harvie256/xmu/README.md

# xMU
An Open Power Grid Measurement Platform

Check out the blog at https://xmuopen.wordpress.com/
