harvie256/xmu/pcb/x_pmu/Datasheets/enclosure/User Library-D6MG.STEP

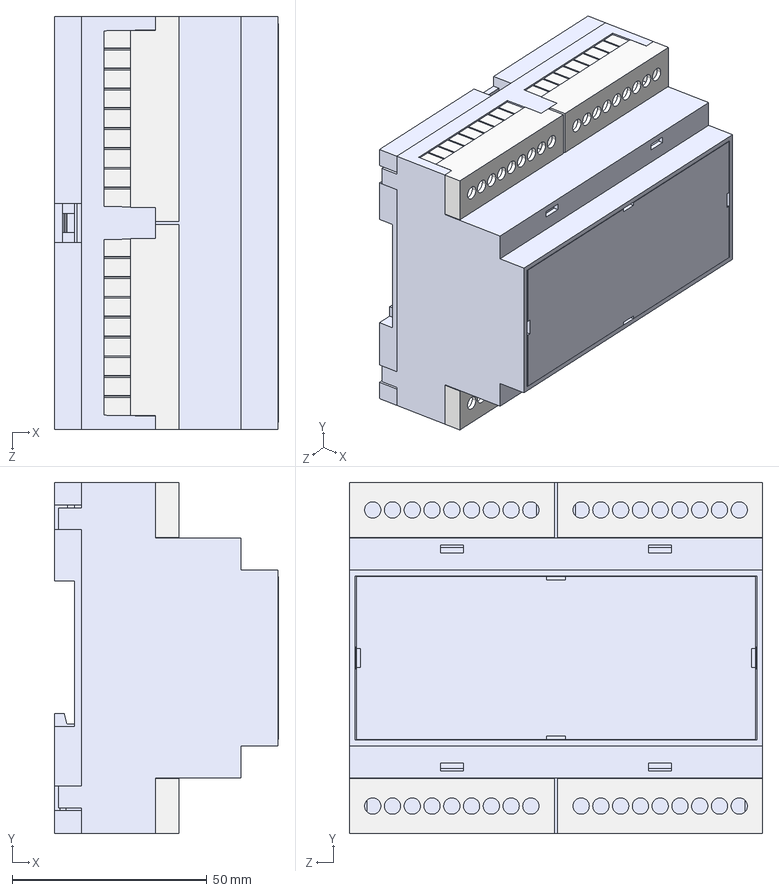
[picture p1: CAD file, 2020-08-02]
pcb/x_pmu/Datasheets/enclosure/User Library-D6MG.STEP
57.6 x 90.2 x 106.3 mm
body-D6MG___ _________
cover-D6MG___ _________
base-D6MG___ _________
guard-D6MG___ _________ x 4
