harvie256/xmu/pcb/x_pmu/Datasheets/enclosure/body-D6MG.step

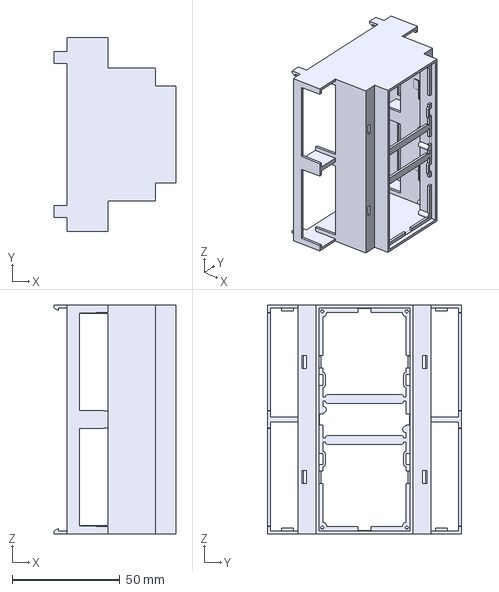
[picture p2: CAD file, 2020-08-02]
pcb/x_pmu/Datasheets/enclosure/body-D6MG.step
56.5 x 90.2 x 106.2 mm
