harvie256/xmu/pcb/x_pmu/x_pmu/x_pmu_project.pdf

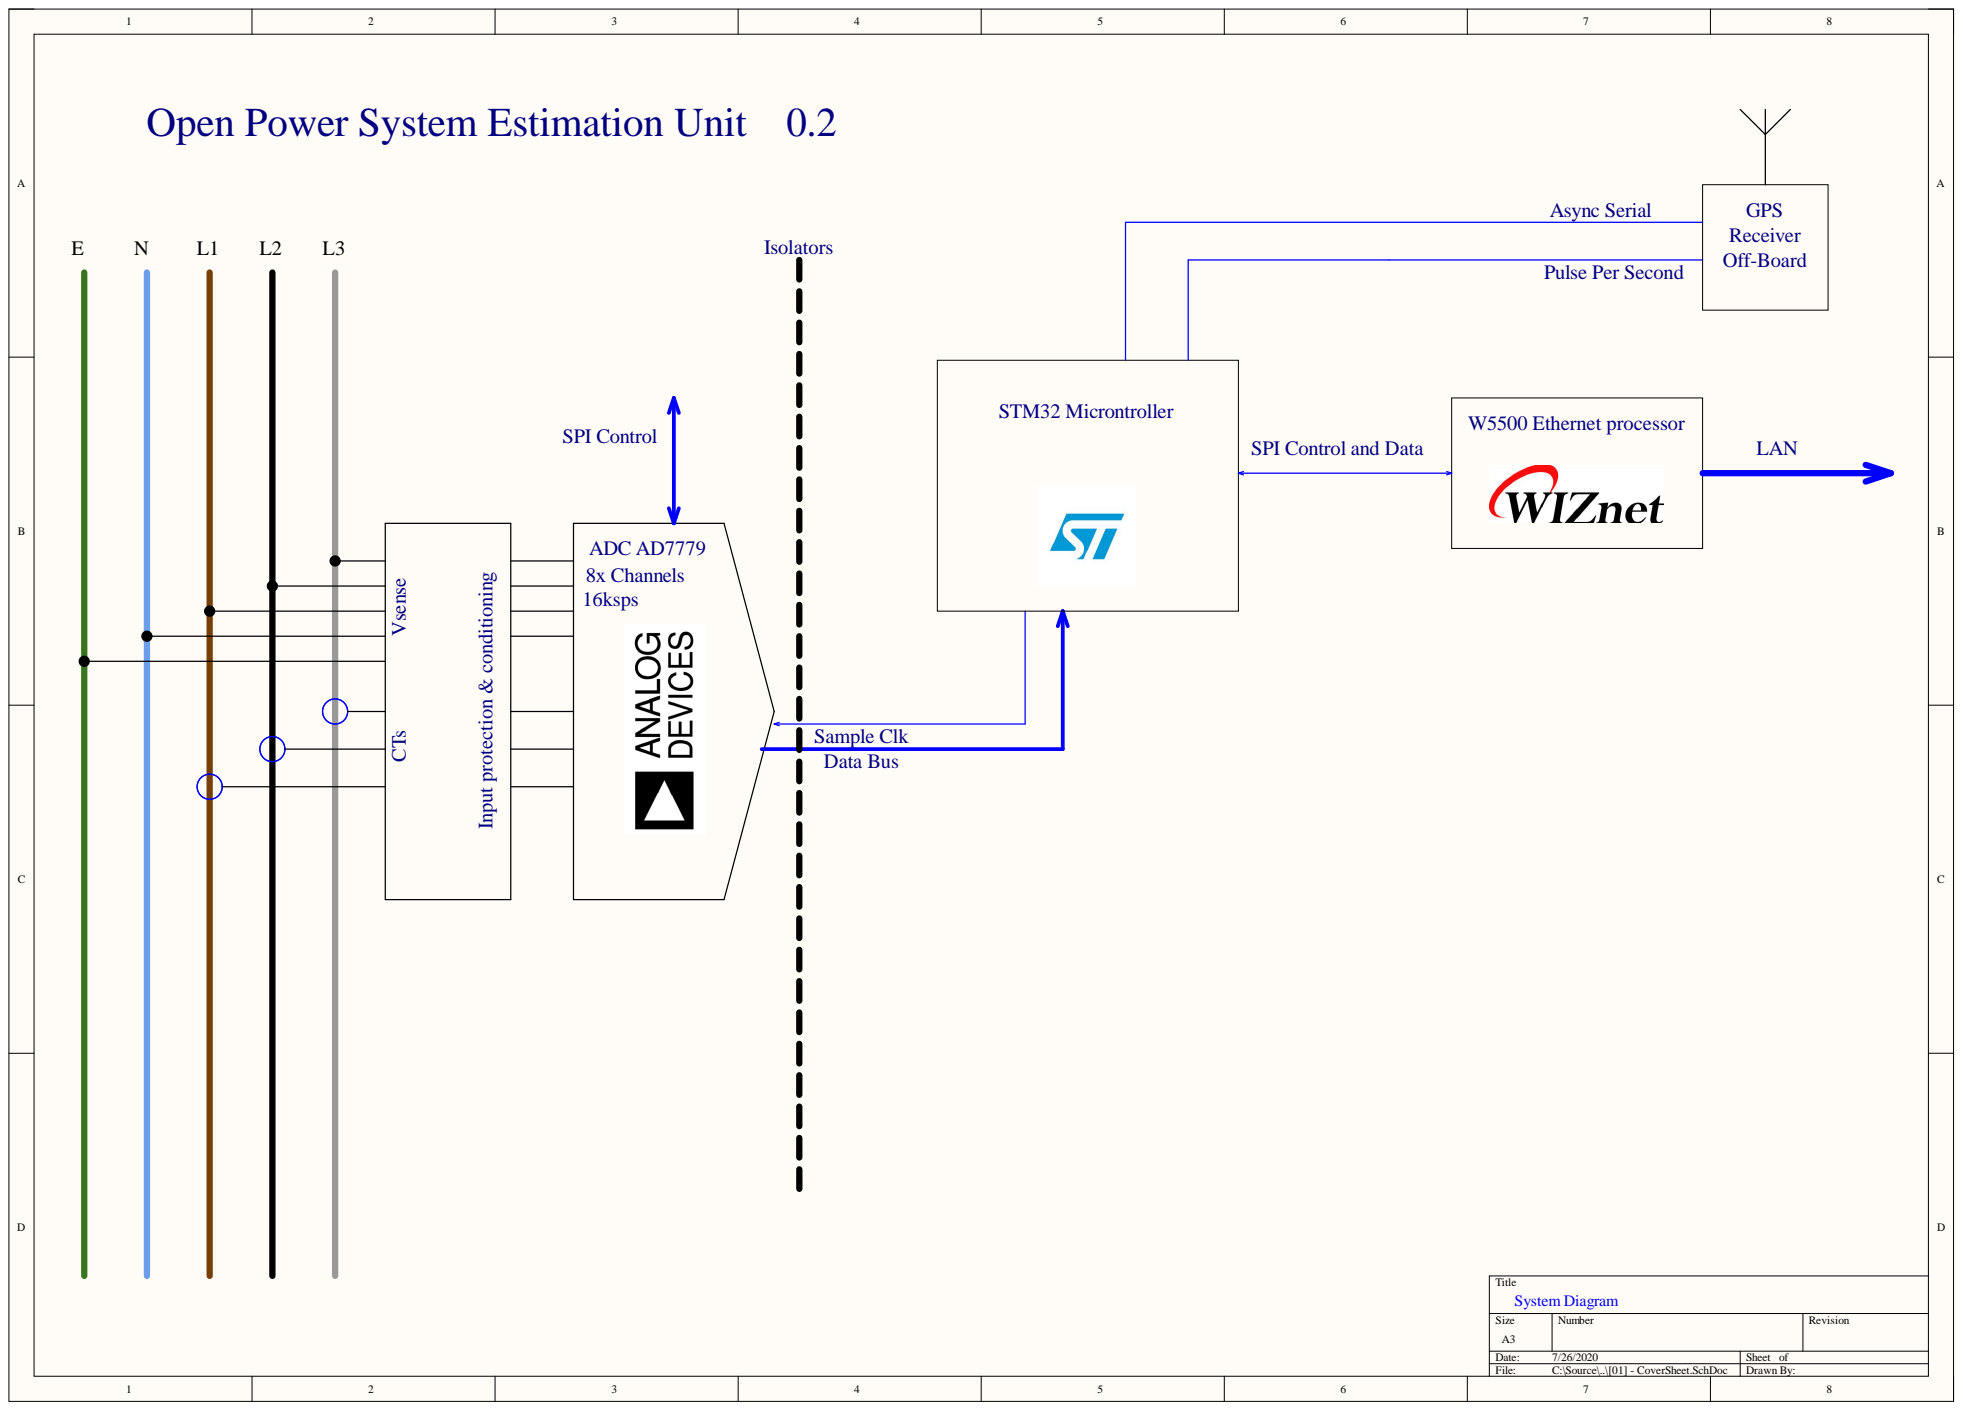
[picture p3: page 1]

Open Power System Estimation Unit 0.2

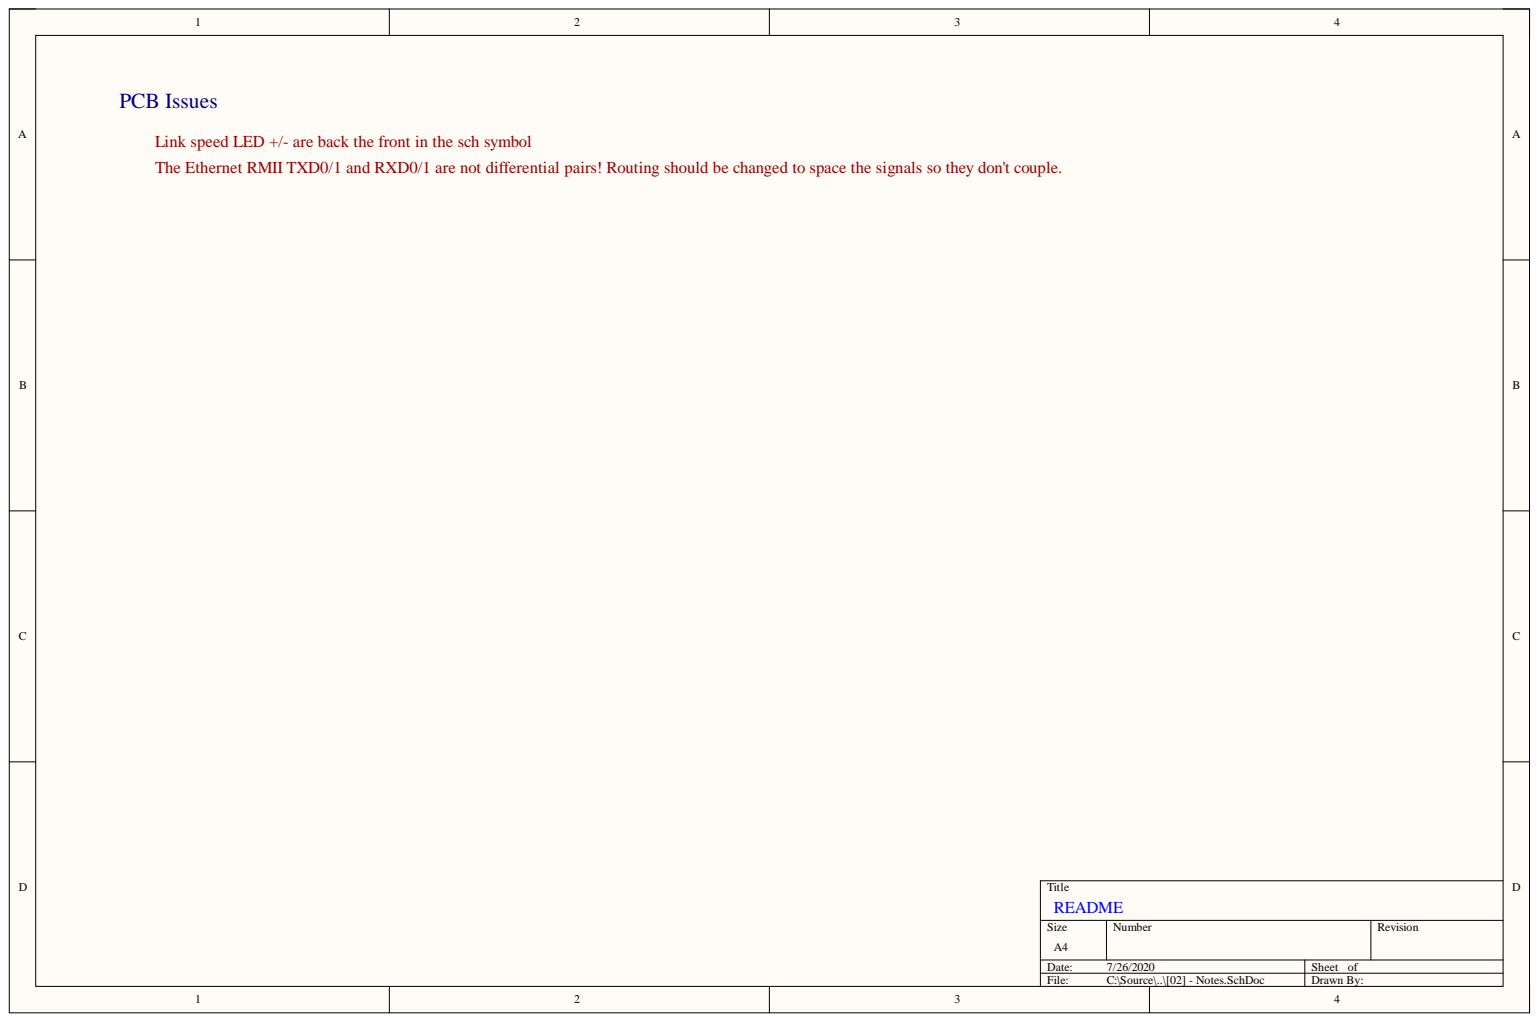
[picture p4: page 2]

Link speed LED +/- are back the front in the sch symbol
The Ethernet RMII TXD0/1 and RXD0/1 are not differential pairs! Routing should be changed to space the signals so they don't couple.

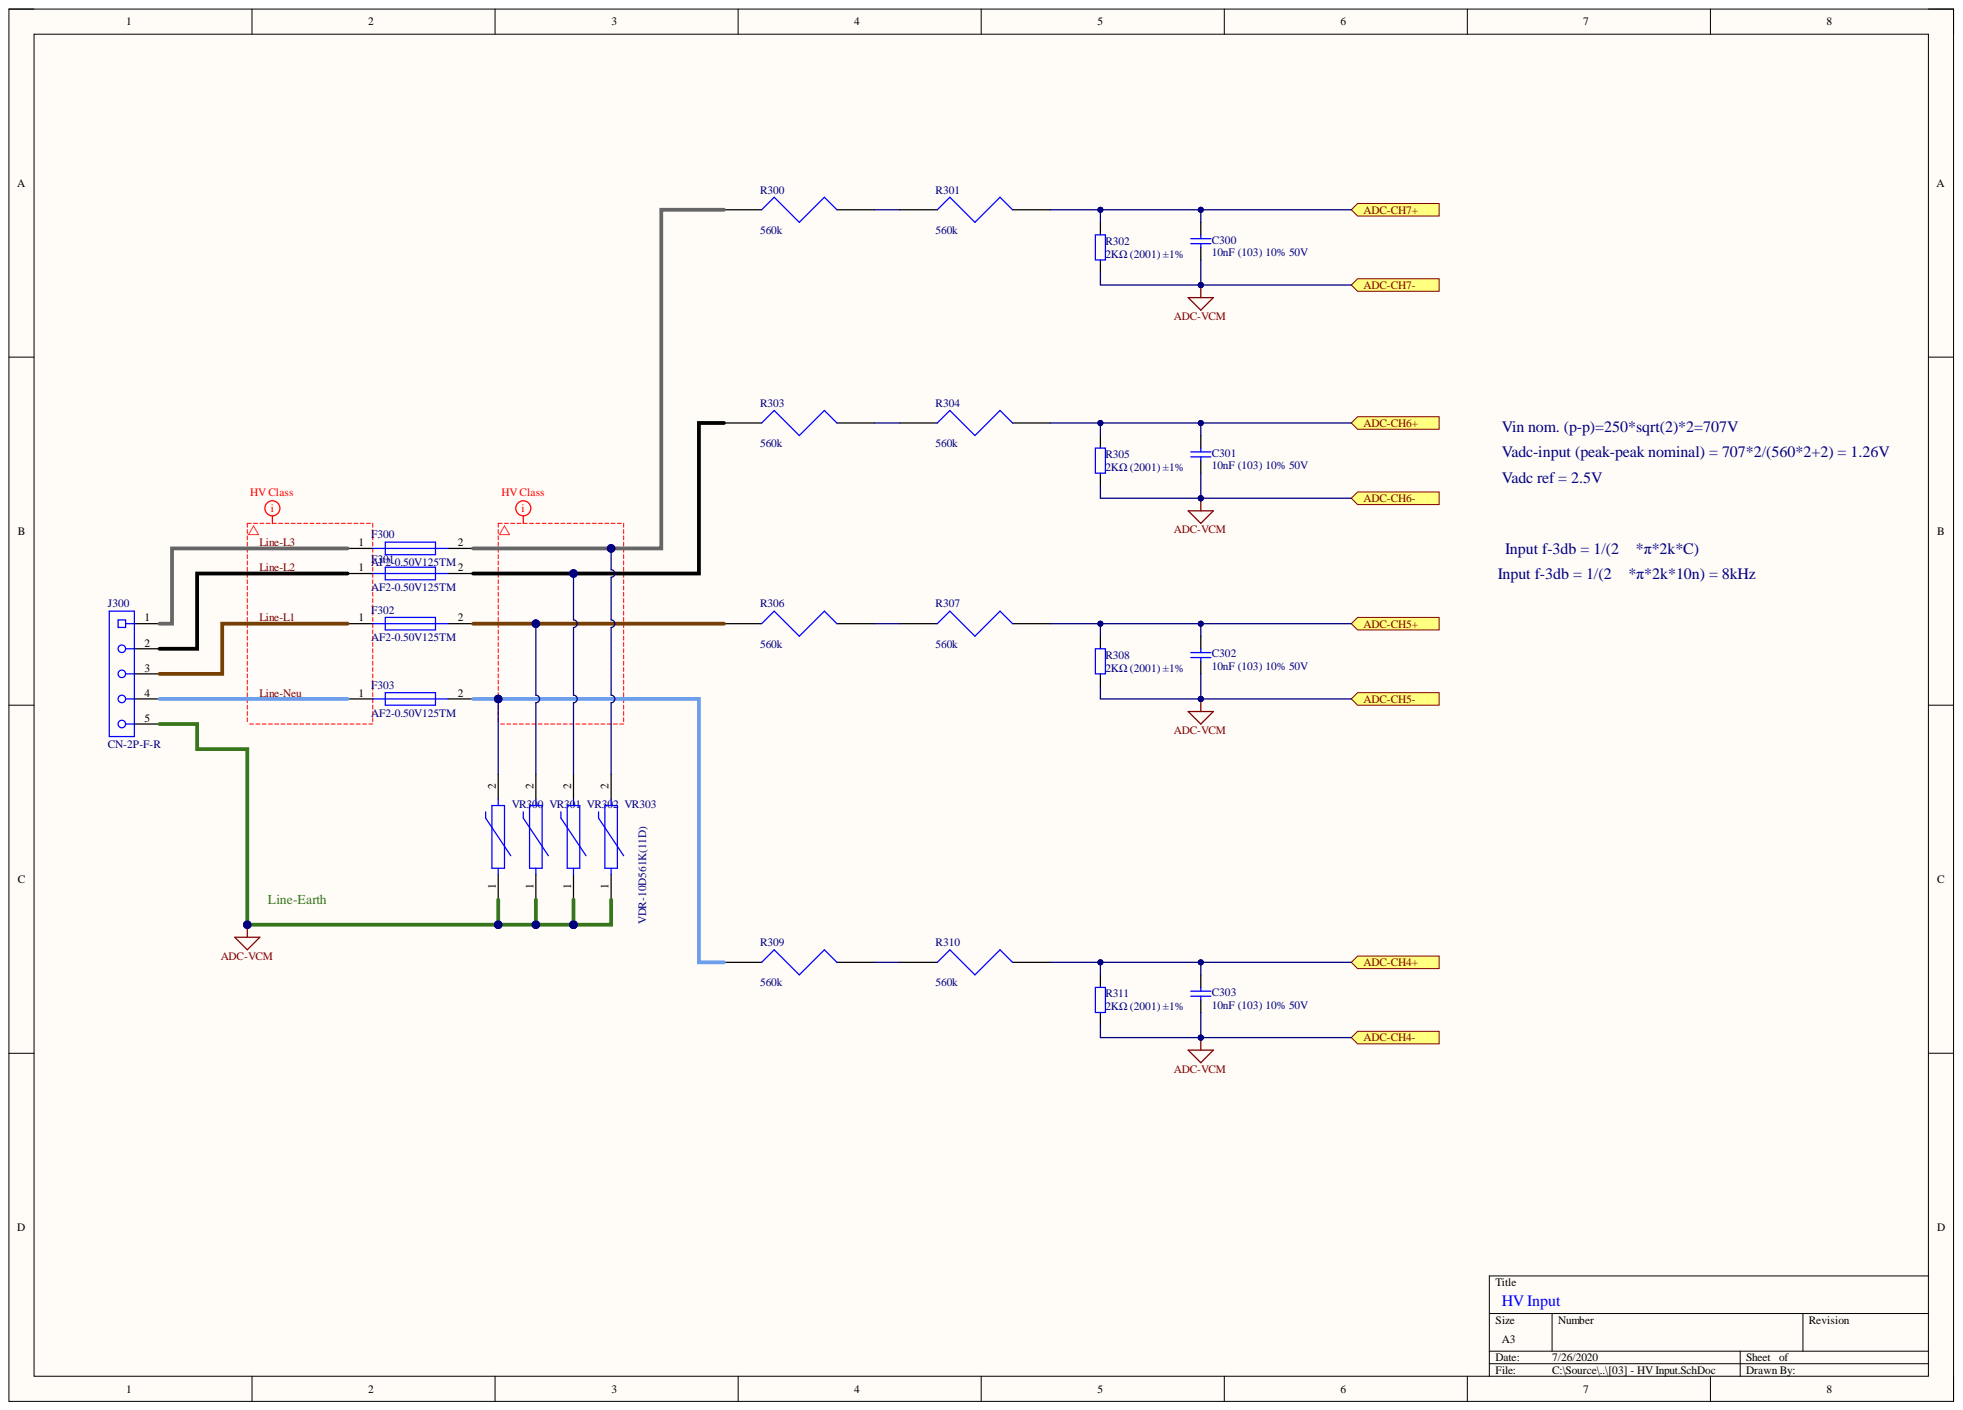
[picture p5: page 3]

Vin nom. (p-p)=250*sqrt(2)*2=707V
Vadc-input (peak-peak nominal) = 707*2/(560*2+2) = 1.26V
Vadc ref = 2.5V

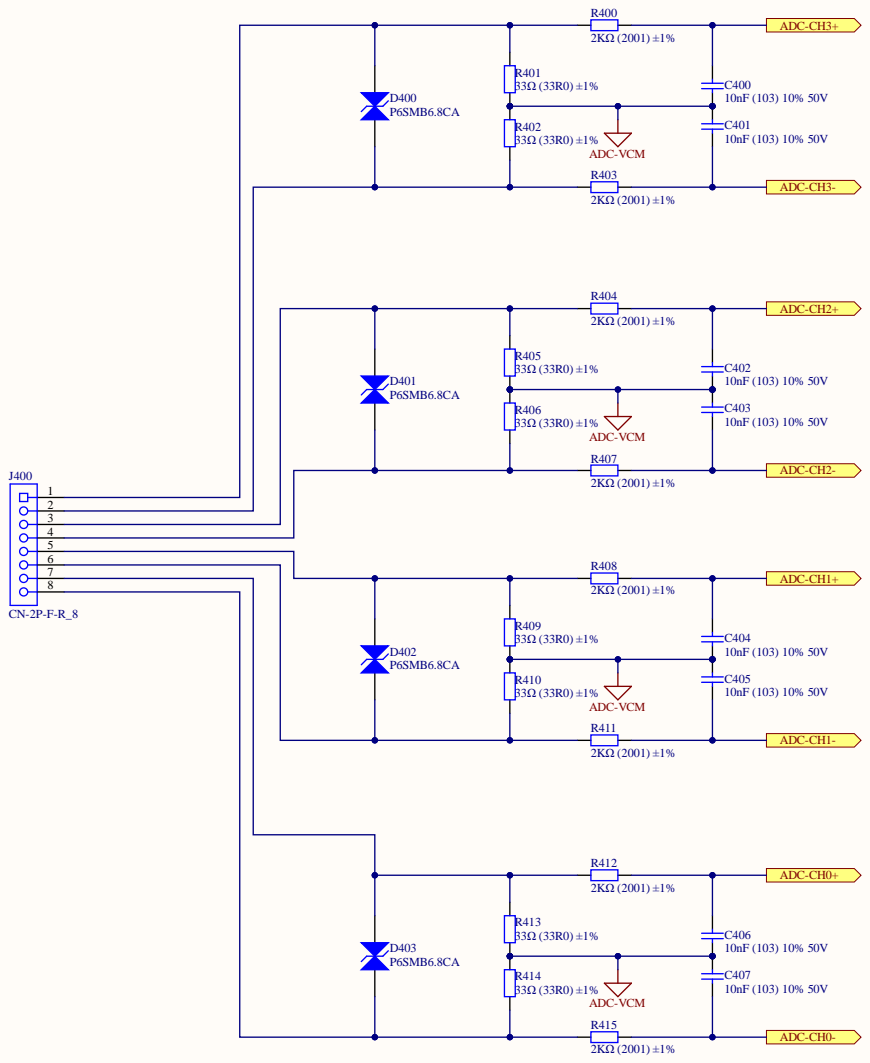
[picture p6: page 4]

GA based Phasor Me

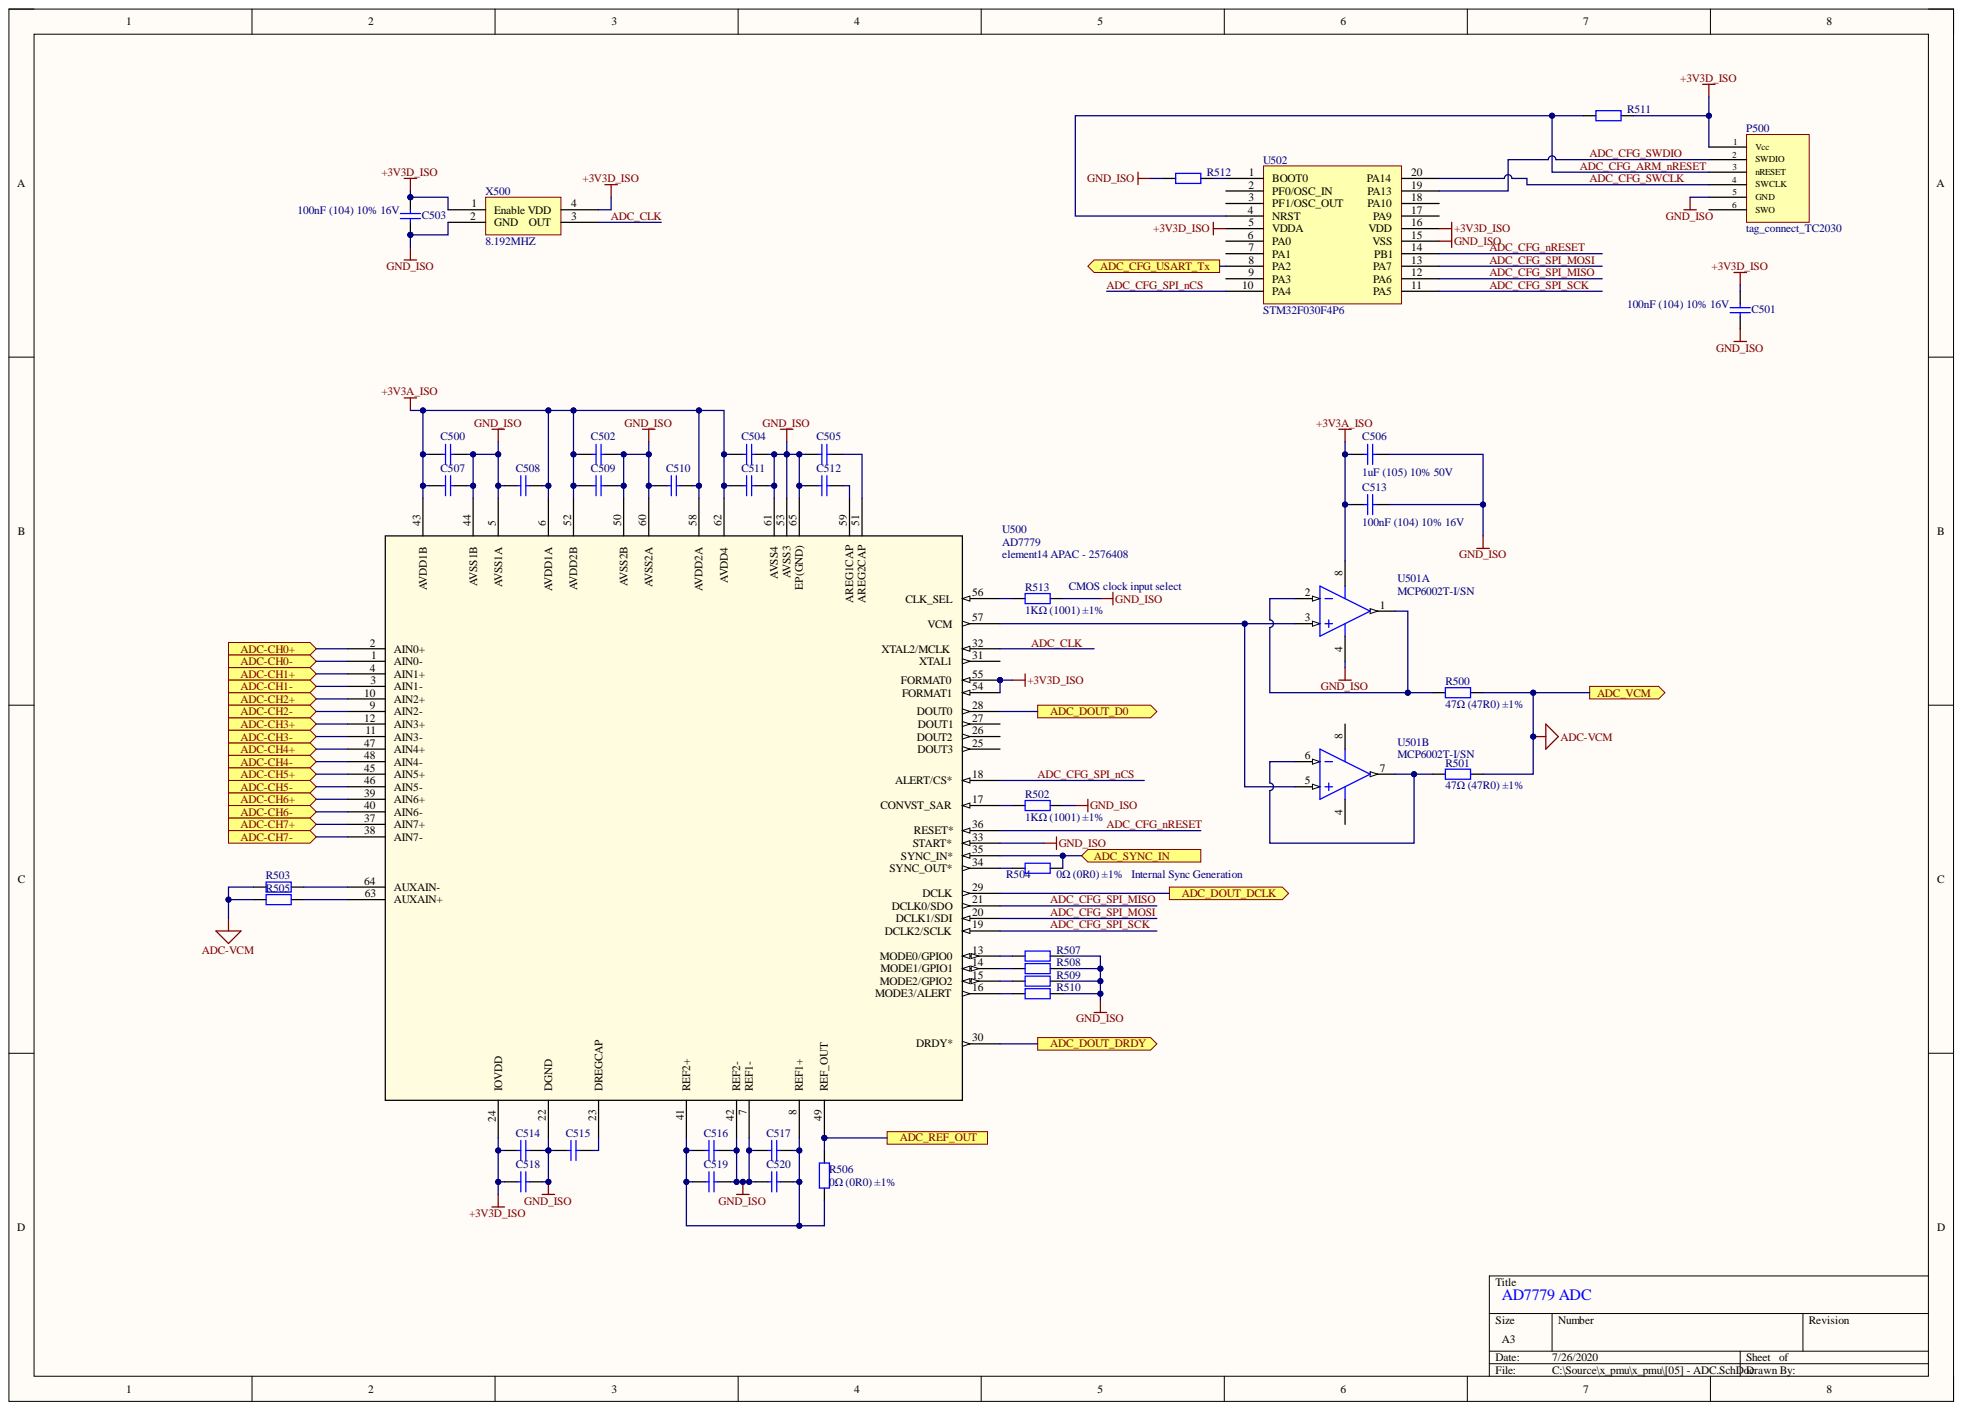
[picture p7: page 5]

CMOS clock input select

ADC_CLK

R508
R509
R510

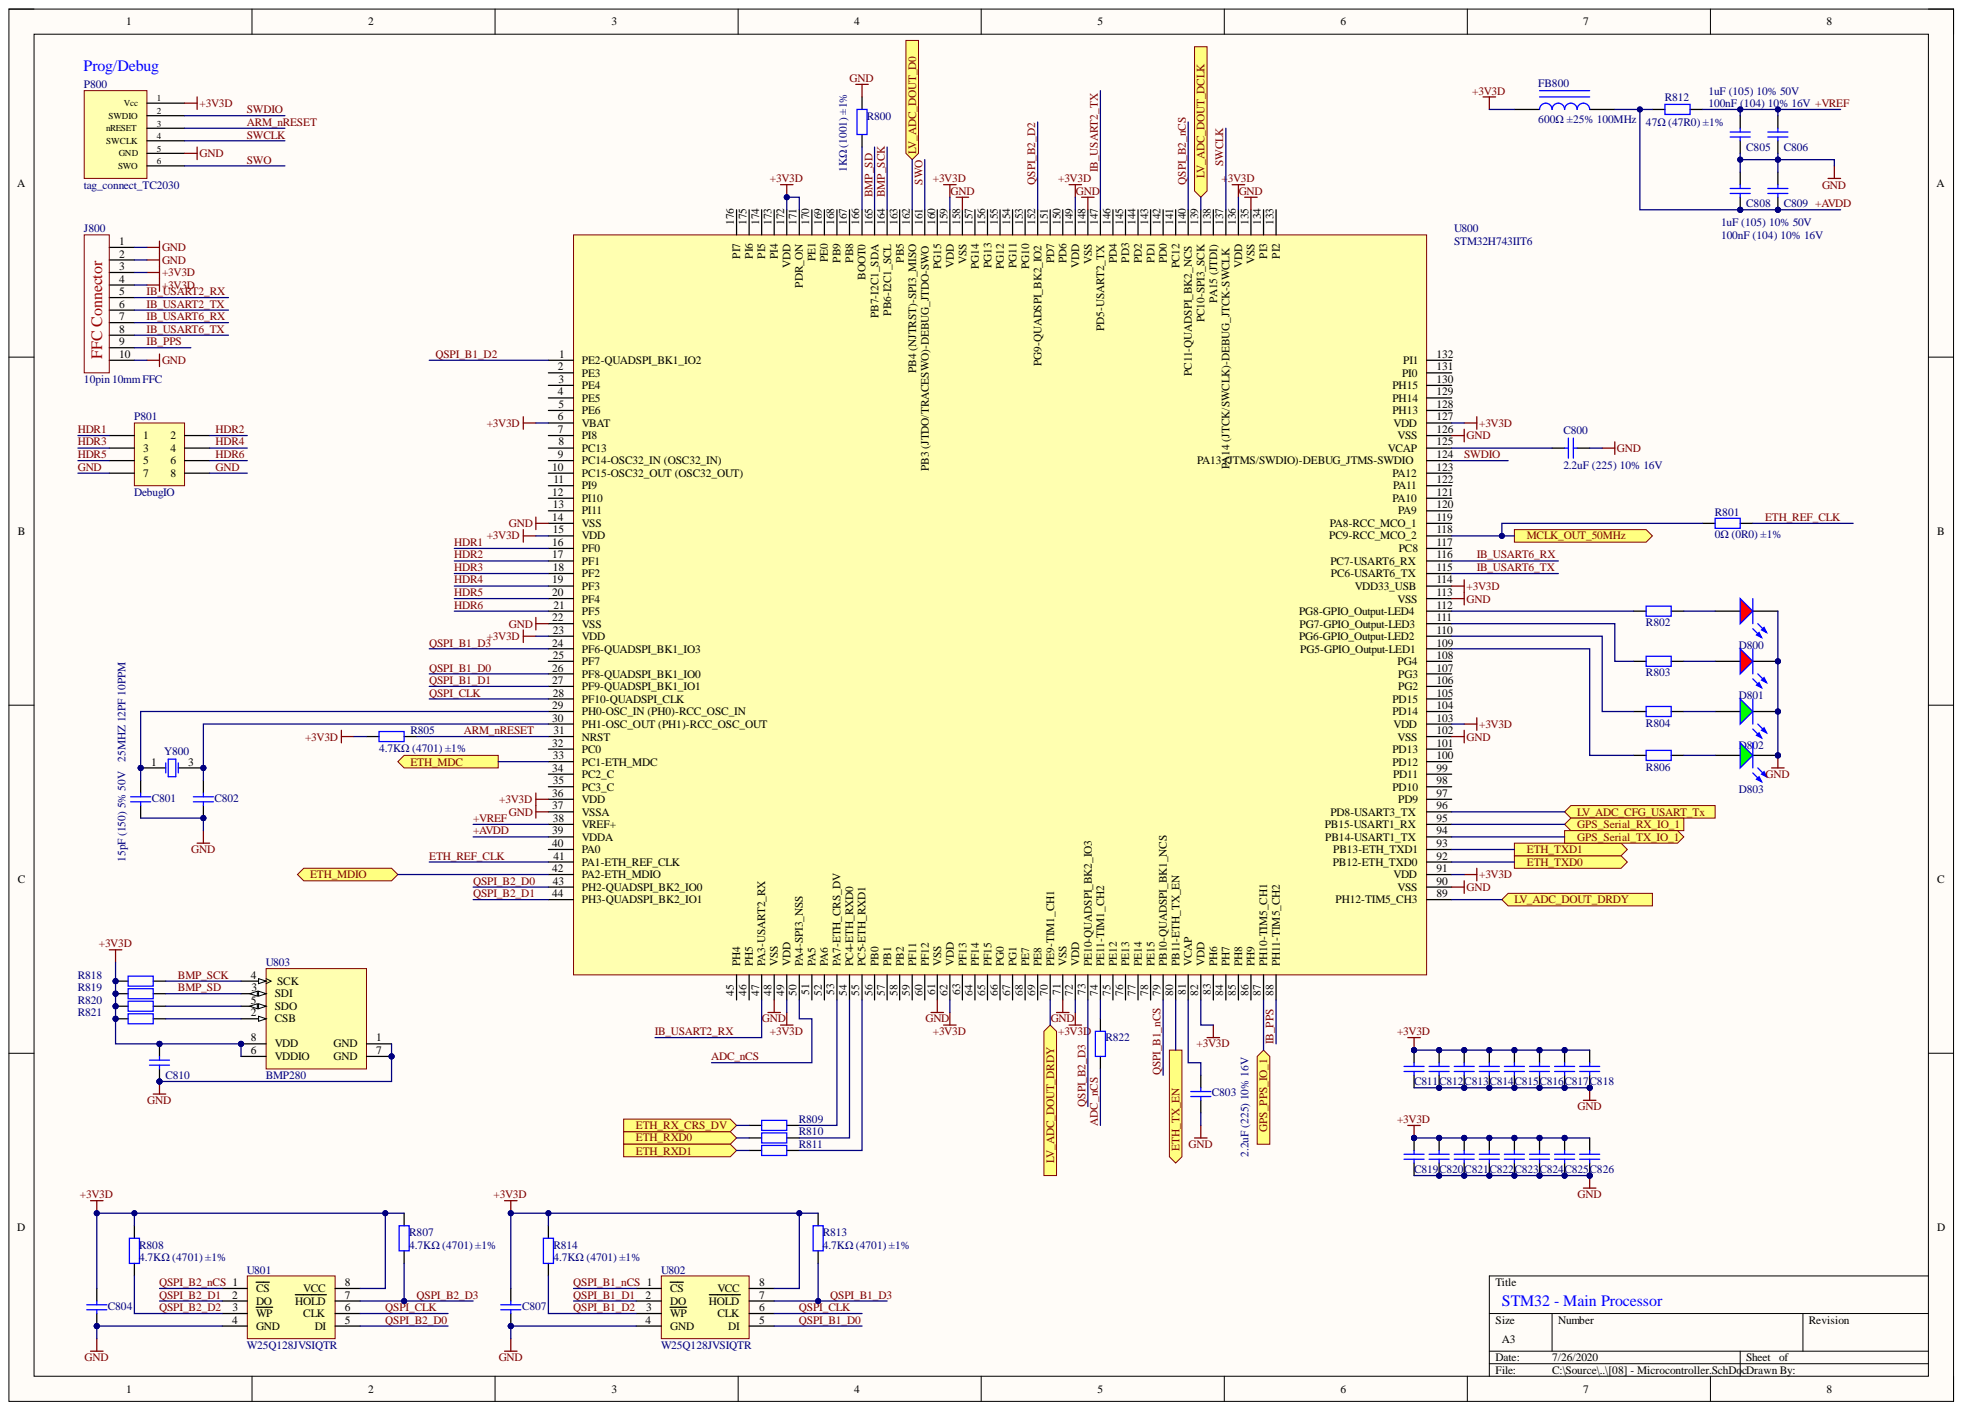
[picture p8: page 6]

PI2 133 PI3 134 VSS 135 VDD 136 PA14 (JTCK/SWCLK)-DEBUG_JTCK-SWCLK 137 PA15 (JTDI) 138 PC10-SPI3_SCK 139 PC11-QUADSPI_BK2_NCS 140 PC12 141 PD0 142 PD1 143 PD2 144 PD3 145 PD4 146 PD5-USART2_TX 147 VSS 148 VDD 149 PD6 150 PD7 151 PG9-QUADSPI_BK2_IO2 152 PG10 153 PG11 154 PG12 155 PG13 156 PG14 157 VSS 158 VDD 159 PG15 160 PB3 (JTDO/TRACESWO)-DEBUG_JTDO-SWO 161 PB4 (NJTRST)-SPI3_MISO 162 PB5 163 PB6-I2C1_SCL 164 PB7-I2C1_SDA 165 BOOT0 166 PB8 167 PB9 168 PE0 169 PE1 170 PDR_ON 171 VDD 172 PI4 173 PI5 174 PI6 175 PI7 176

PF8-QUADSPI_BK1_IO0 26 PF9-QUADSPI_BK1_IO1 27 PF10-QUADSPI_CLK 28 PH0-OSC_IN (PH0)-RCC_OSC_IN 29 | | D801

PH1-OSC_OUT (PH1)-RCC_OSC_OUT 30 | | D802

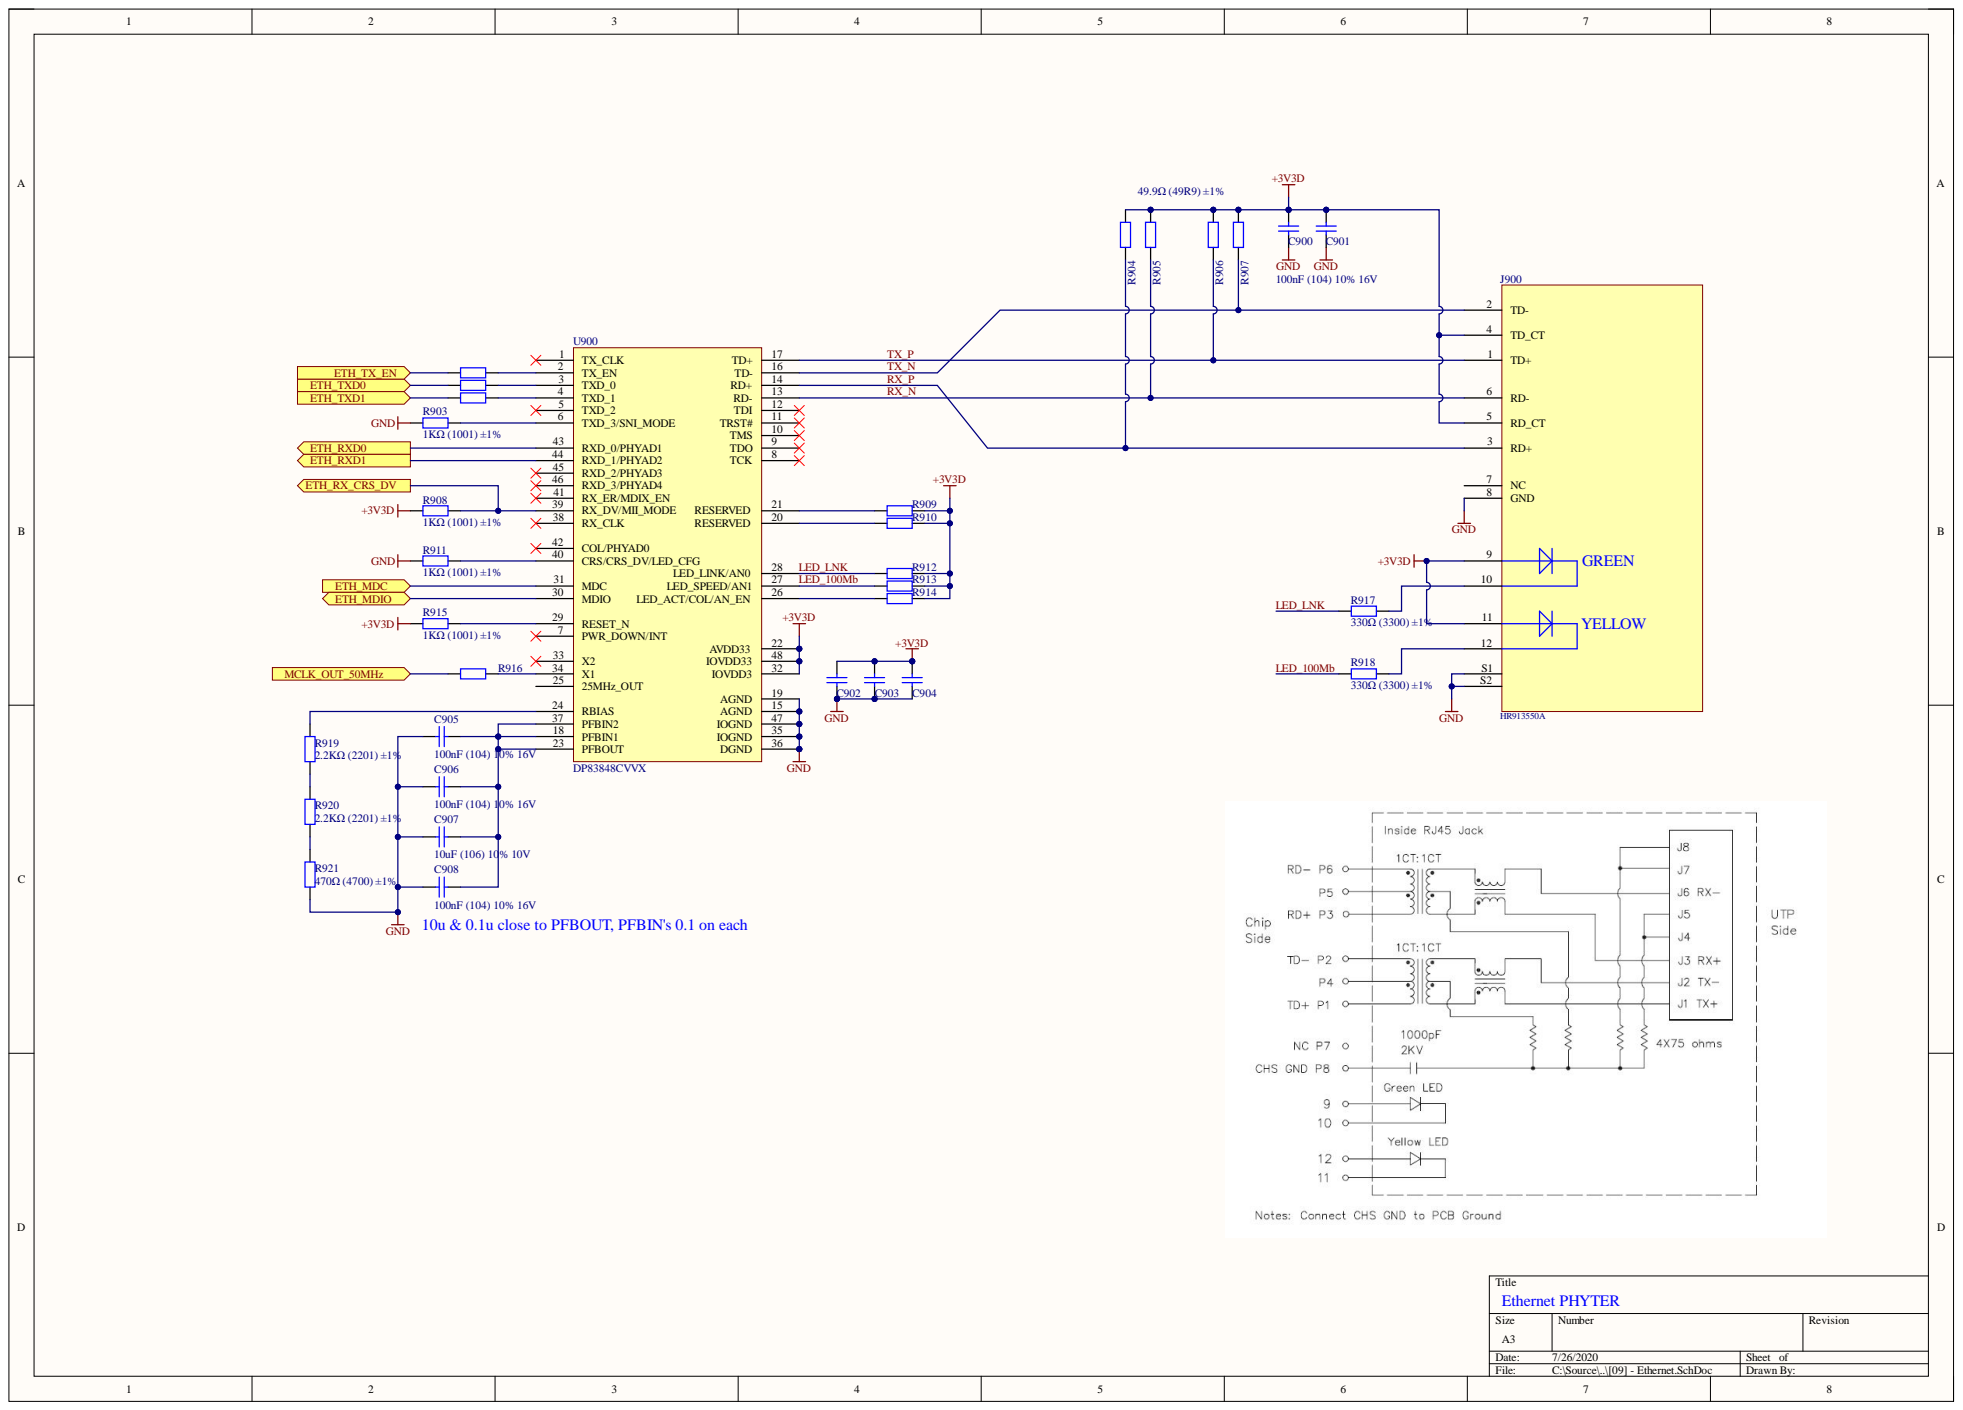
[picture p9: page 7]

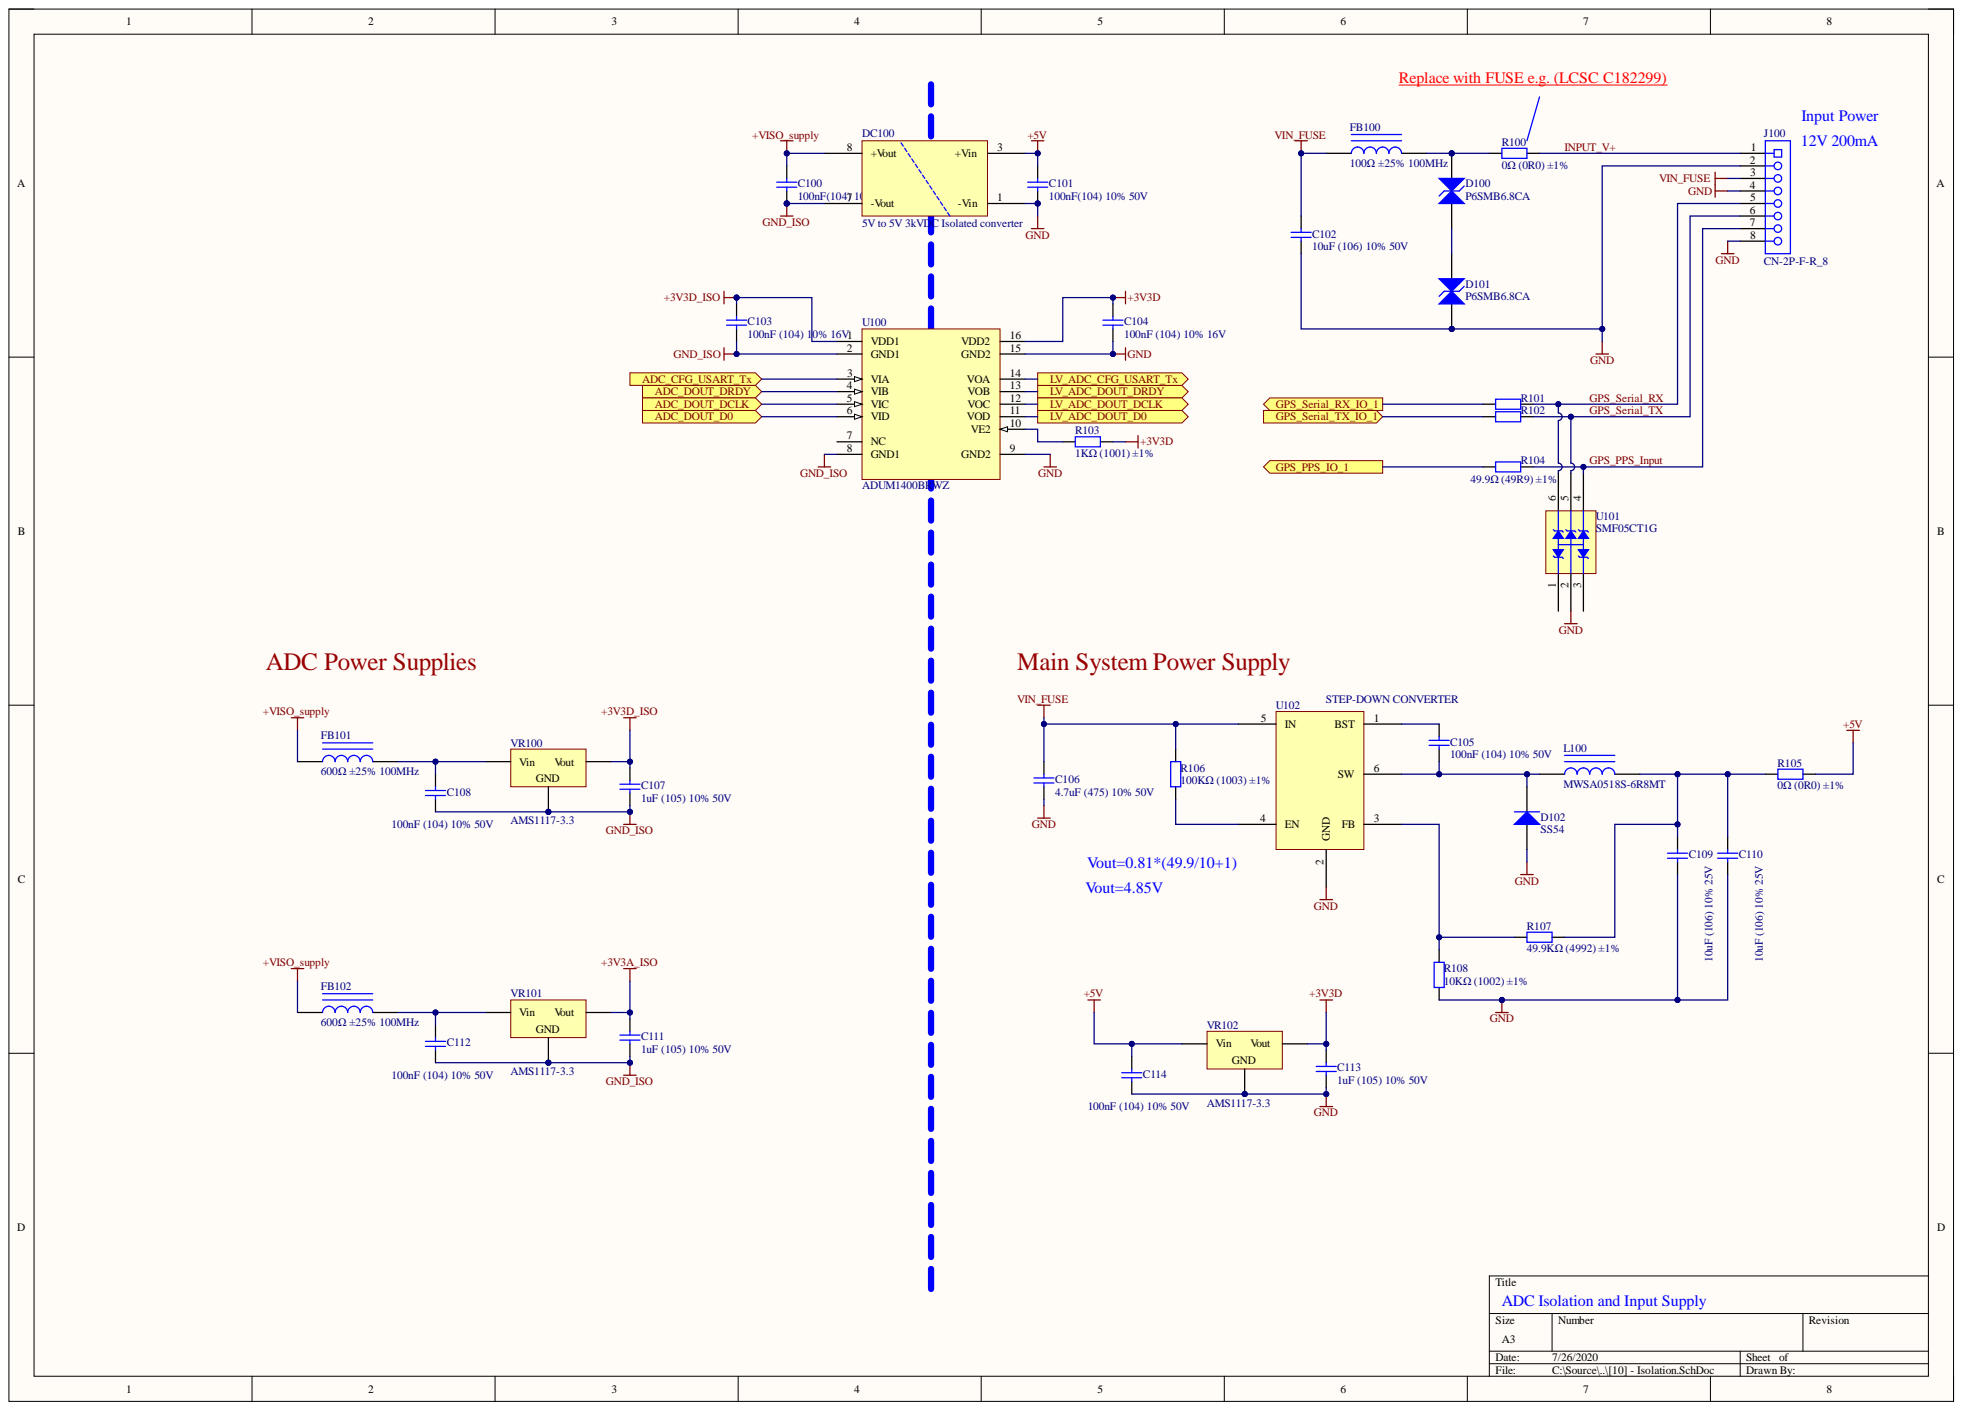
[picture p10: page 8]

Replace with FUSE e.g. (LCSC C182299)

VIN_FUSE GND | 3

D101 P6SMB6.8CA | GND

VDD1 1

Title
ADC Isolation and Input Supply

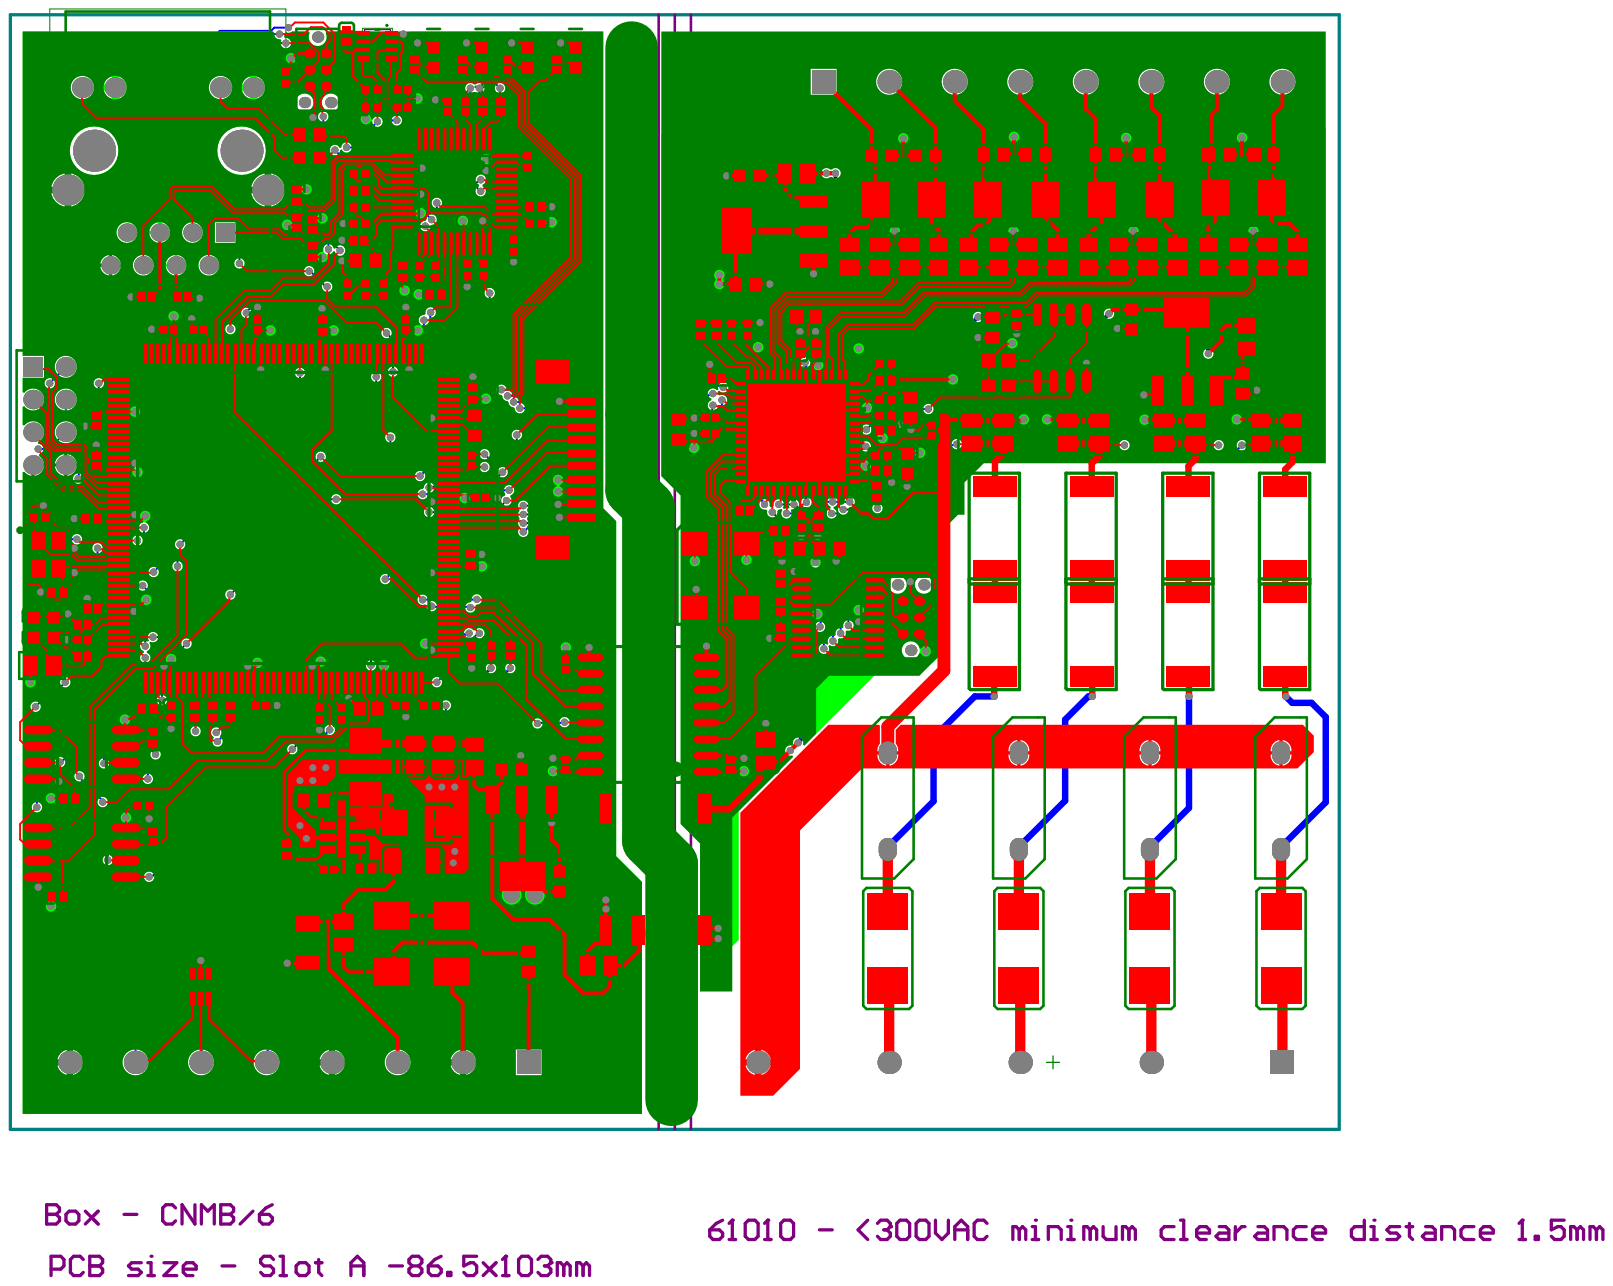
[picture p11: page 9]
