harvie256/xmu/(list of files, drawings)

Other design files:
pcb/x_pmu/x_pmu/[01] - CoverSheet.SchDoc
pcb/x_pmu/x_pmu/[02] - Notes.SchDoc
pcb/x_pmu/x_pmu/[03] - HV Input.SchDoc
pcb/x_pmu/x_pmu/[04] - Current Transformers.SchDoc
pcb/x_pmu/x_pmu/[05] - ADC.SchDoc
pcb/x_pmu/x_pmu/[06] - FPGA Aux.SchDoc
pcb/x_pmu/x_pmu/[07] - FPGA IO.SchDoc
pcb/x_pmu/x_pmu/[08] - Microcontroller.SchDoc
pcb/x_pmu/x_pmu/[09] - Ethernet.SchDoc
pcb/x_pmu/x_pmu/[10] - Isolation.SchDoc
pcb/x_pmu/x_pmu/x_pmu_project.PrjPcb
pcb/x_pmu/x_pmu/xPMU_lib.PcbLib
pcb/x_pmu/x_pmu/xPMU_lib.SchLib
