harvie256/xmu/firmware/xPmu_H7/xPmu_H7.ioc

Mcu.UserName=STM32H743IITx
PA1.Signal=ETH_REF_CLK
PA2.Signal=ETH_MDIO
PA3.Signal=USART2_RX
PA4.Signal=SPI3_NSS
PA7.Signal=ETH_CRS_DV
PB10.Signal=QUADSPI_BK1_NCS
PB11.Signal=ETH_TX_EN
PB12.Signal=ETH_TXD0
PB13.Signal=ETH_TXD1
PB14.Signal=USART1_TX
PB15.Signal=USART1_RX
PB6.Signal=I2C1_SCL
PB7.Signal=I2C1_SDA
PC1.Signal=ETH_MDC
PC10.Signal=SPI3_SCK
PC11.Signal=QUADSPI_BK2_NCS
PC4.Signal=ETH_RXD0
PC5.Signal=ETH_RXD1
PC6.Signal=USART6_TX
PC7.Signal=USART6_RX
PC9.Signal=RCC_MCO_2
PD5.Signal=USART2_TX
PD8.Signal=USART3_TX
PE10.Signal=QUADSPI_BK2_IO3
PE11.Signal=S_TIM1_CH2
PE2.Signal=QUADSPI_BK1_IO2
PE9.Signal=S_TIM1_CH1
PF0.GPIO_Label=DEBUG_PIN_1
PF0.Signal=GPIO_Output
PF10.Signal=QUADSPI_CLK
PF6.Signal=QUADSPI_BK1_IO3
PF8.Signal=QUADSPI_BK1_IO0
PF9.Signal=QUADSPI_BK1_IO1
PG5.GPIO_Label=LED1
PG5.Signal=GPIO_Output
PG6.GPIO_Label=LED2
PG6.Signal=GPIO_Output
PG7.GPIO_Label=LED3
PG7.Signal=GPIO_Output
PG8.GPIO_Label=LED4
PG8.Signal=GPIO_Output
PG9.Signal=QUADSPI_BK2_IO2
PH10.Signal=S_TIM5_CH1
PH11.Signal=S_TIM5_CH2
PH12.Signal=S_TIM5_CH3
PH2.Signal=QUADSPI_BK2_IO0
PH3.Signal=QUADSPI_BK2_IO1
