harvie256/xmu/firmware/xPmu_H7/Core/Inc/main.h

#define DEBUG_PIN_1_Pin GPIO_PIN_0
#define DEBUG_PIN_1_GPIO_Port GPIOF
#define LED1_Pin GPIO_PIN_5
#define LED1_GPIO_Port GPIOG
#define LED2_Pin GPIO_PIN_6
#define LED2_GPIO_Port GPIOG
#define LED3_Pin GPIO_PIN_7
#define LED3_GPIO_Port GPIOG
#define LED4_Pin GPIO_PIN_8
#define LED4_GPIO_Port GPIOG
