harvie256/xmu/(commit log)

2020-08-02 Added xmu main pcb
    [Pick Place for x_pmu_board.csv, User Library-D6MG.STEP, [01] - CoverSheet.SchDoc, [02] - Notes.SchDoc, [03] - HV Input.SchDoc, [04] - Current Transformers.SchDoc, [05] - ADC.SchDoc, [06] - FPGA Aux.SchDoc]
2020-08-03 Added firmware folder with M0 and M7 projects
    [PinConfig.txt]
2020-08-03 fixed stm32 gitignore
